oliverchang/sucima/README.md

# Sucima

## What is this?

This is the code for a controller for the Amicus Basic/Advance/Professional
table tennis robots, and a PWA for interfacing with it using bluetooth.
