oliverchang/sucima/pcb/README.md

This directory contains design files for the controller PCB.

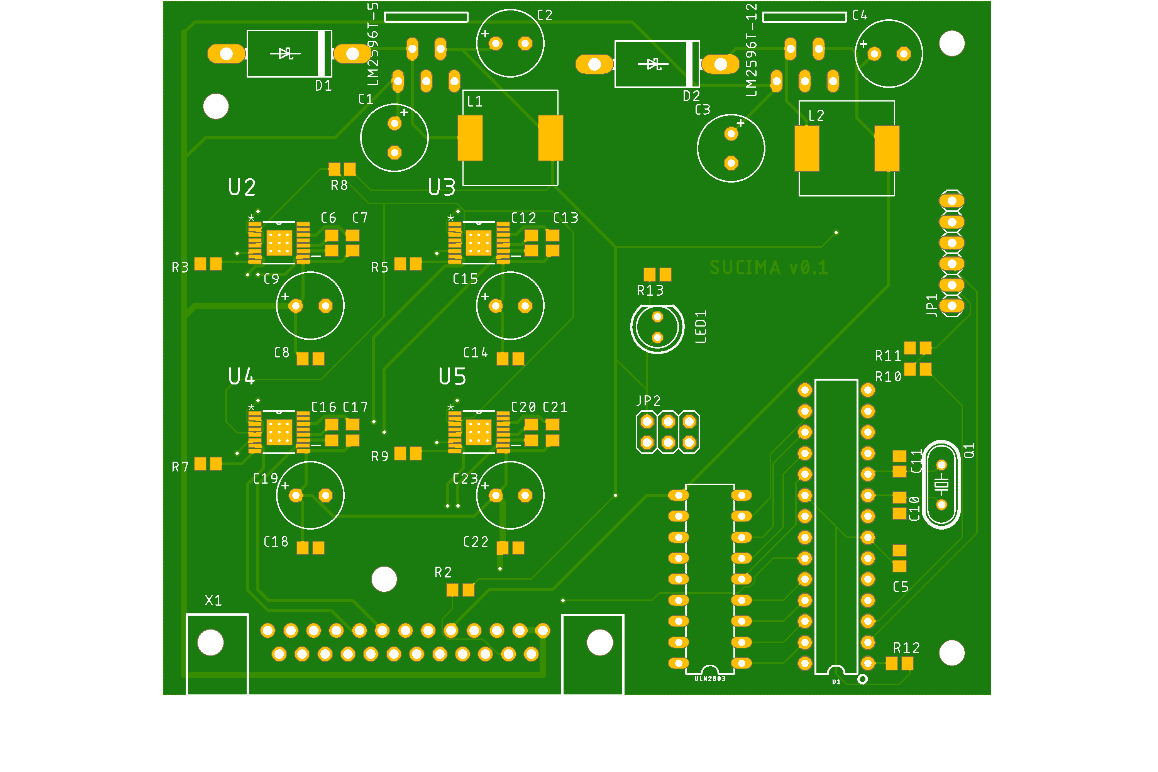
[picture p1: pcb/front.png]
front
