oliverchang/sucima/case/Bottom.stl

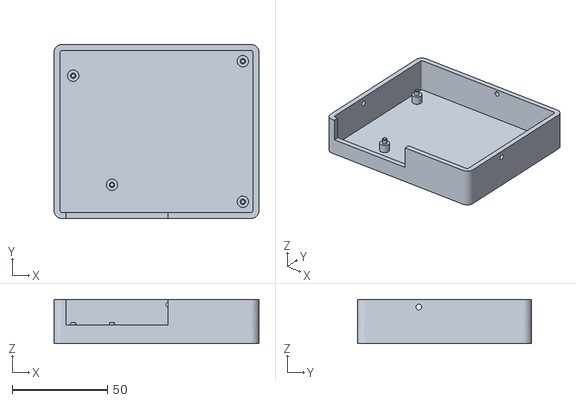
[picture p2: CAD file, 2019-05-30]
case/Bottom.stl
107.4 x 91.2 x 23.2
