oliverchang/sucima/case/Top.stl

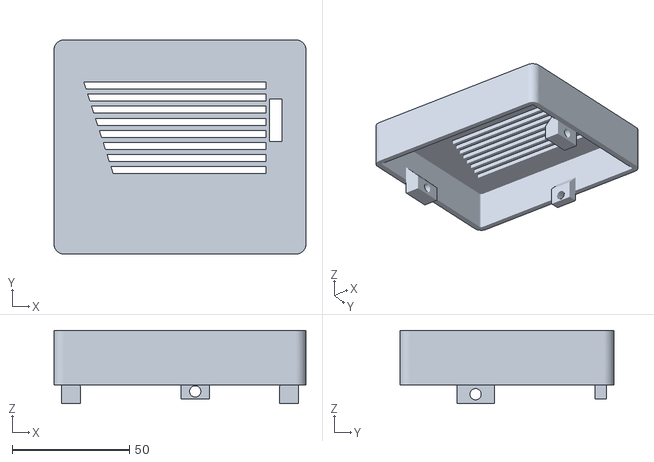
[picture p3: CAD file, 2019-05-30]
case/Top.stl
107.4 x 91.2 x 31.2
