oliverchang/sucima/pcb/board.brd

## EAGLE design pcb/board.brd (2019-04-11)

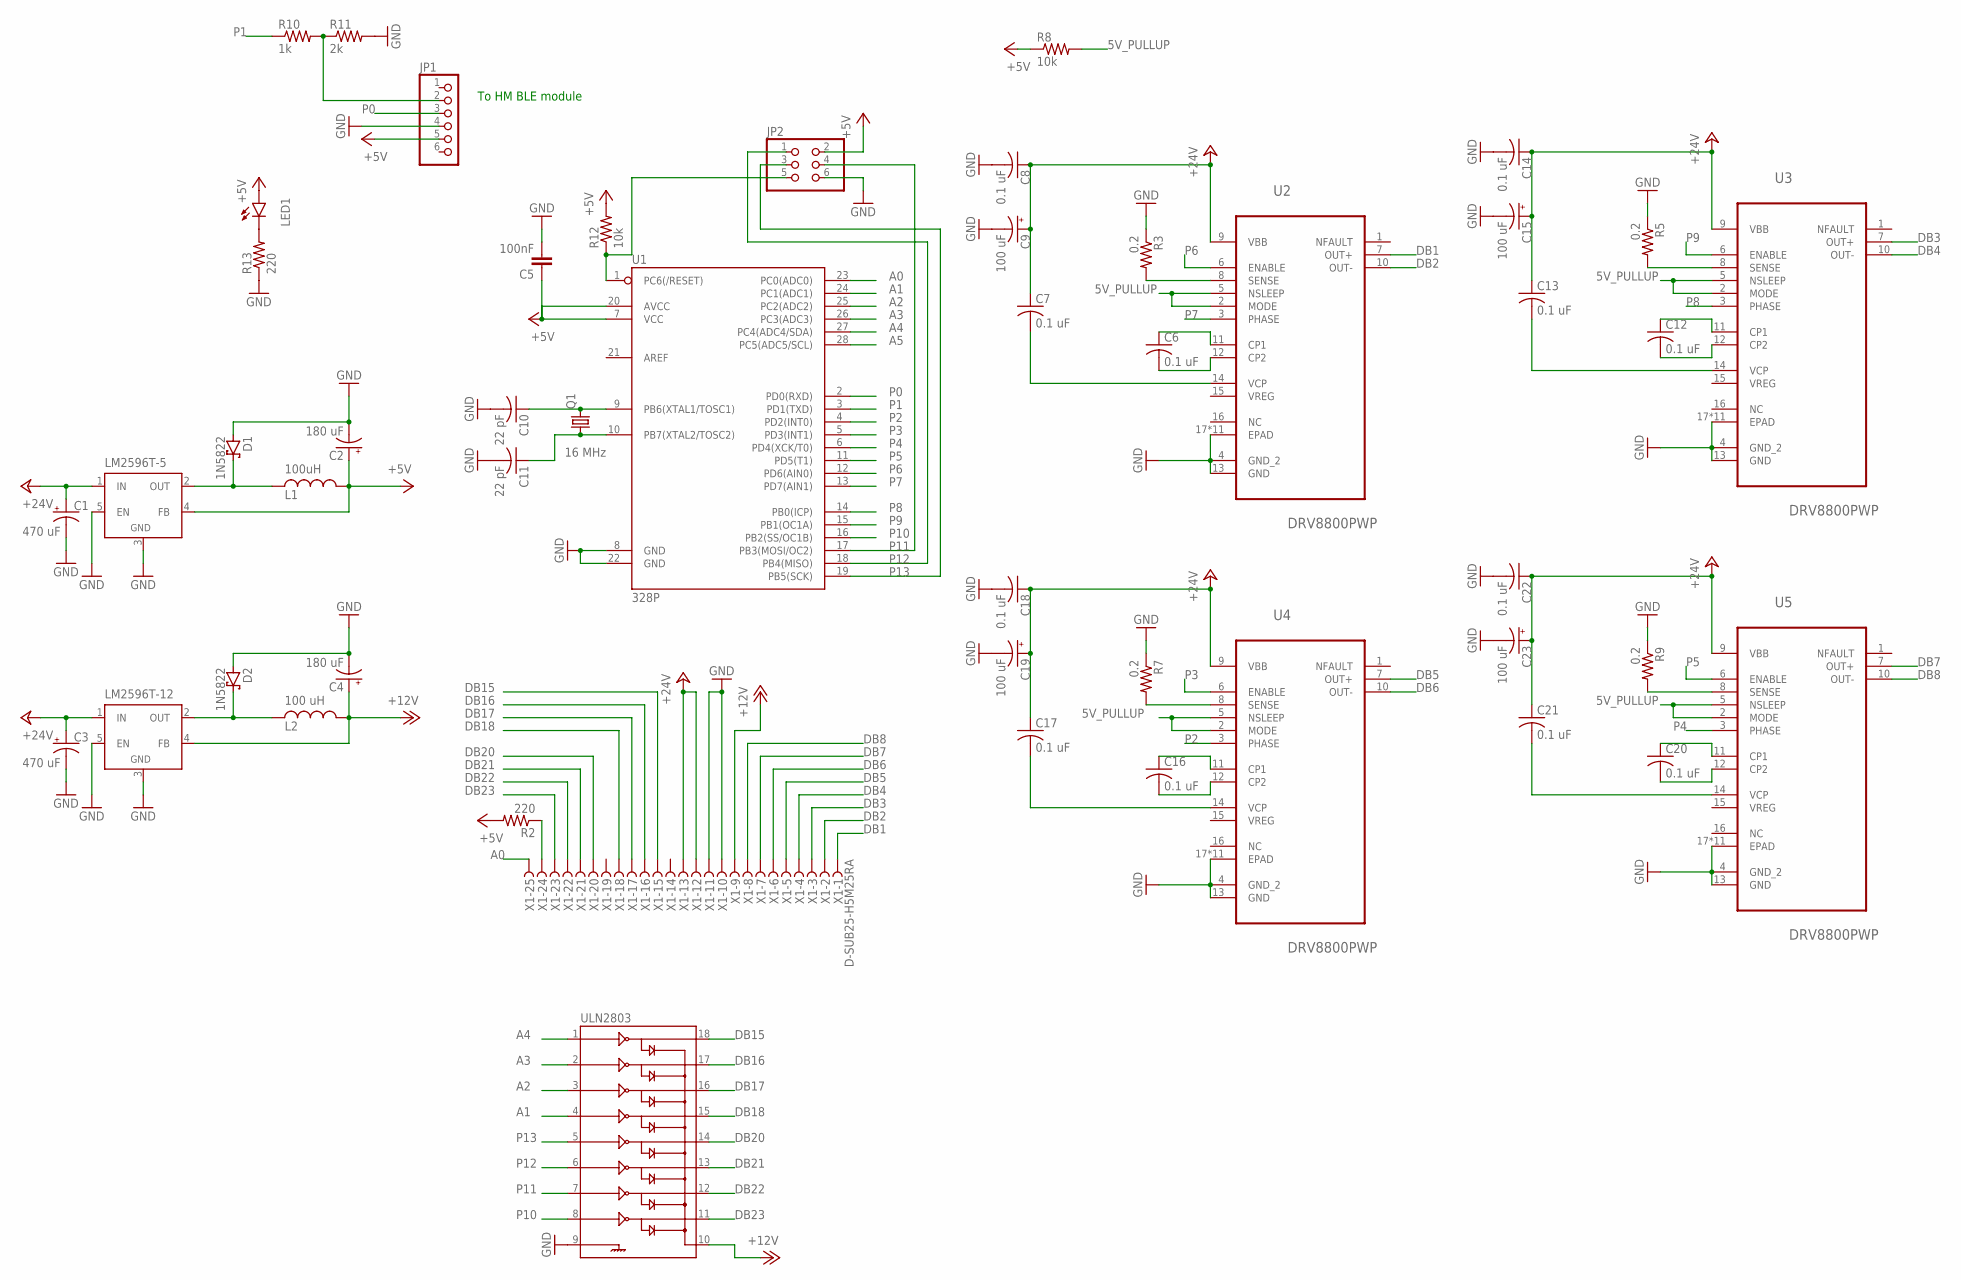
[picture p4: schematic board.sch]

Parts:
C1, C3: 470 uF; E3,5-8
C2, C4: 180 uF; E3,5-8
C5: 100nF; C0805
C6, C7, C8, C12, C13, C14, C16, C17, C18, C20, C21, C22: 0.1 uF; C0805
C9, C15, C19, C23: 100 uF; E3,5-8
C10, C11: 22 pF; C0805
D1, D2: 1N5822; DO201T15
JP1: PINHD-1X6; 1X06
JP2: PINHD-2X3; 2X03
L1: 100uH; SRR1260
L2: 100 uH; SRR1260
LED1: LED5MM
LM2596T-5, LM2596T-12: LM2596TV; TO220-51
Q1: 16 MHz; HC49/S
R2, R13: 220; R0805
R3, R5, R7, R9: 0.2; R0805
R8, R12: 10k; R0805
R10: 1k; R0805
R11: 2k; R0805
U1: 328P; DIP28
U2, U3, U4, U5: DRV8800PWP; SOP65P640X120-17N
ULN2803: ULN2803DIP; DIL18
X1: D-SUB25-H5M25RA; H5M25RA

Connections:
5V_PULLUP: R8.2, U2.2 (MODE), U2.5 (NSLEEP), U3.2 (MODE), U3.5 (NSLEEP), U4.2 (MODE), U4.5 (NSLEEP), U5.2 (MODE), U5.5 (NSLEEP)
+5V: C2.+, C5.1, JP1.5, JP2.2, L1.2, LED1.A, LM2596T-5.4 (FB), R2.2, R8.1, R12.2, U1.7 (VCC), U1.20 (AVCC)
+12V: C4.+, L2.2, LM2596T-12.4 (FB), ULN2803.10, X1.9
+24V: C1.+, C3.+, C7.1, C8.1, C9.+, C13.1, C14.1, C15.+, C17.1, C18.1, C19.+, C21.1, C22.1, C23.+, LM2596T-5.1 (IN), LM2596T-12.1 (IN), U2.9 (VBB), U3.9 (VBB), U4.9 (VBB), U5.9 (VBB), X1.12, X1.13
A0: U1.23 (PC0(ADC0)), X1.25
A1: U1.24 (PC1(ADC1)), ULN2803.4
A2: U1.25 (PC2(ADC2)), ULN2803.3
A3: U1.26 (PC3(ADC3)), ULN2803.2
A4: U1.27 (PC4(ADC4/SDA)), ULN2803.1
A5: U1.28 (PC5(ADC5/SCL))
DB1: U2.7 (OUT+), X1.1
DB2: U2.10 (OUT-), X1.2
DB3: U3.7 (OUT+), X1.3
DB4: U3.10 (OUT-), X1.4
DB5: U4.7 (OUT+), X1.5
DB6: U4.10 (OUT-), X1.6
DB7: U5.7 (OUT+), X1.7
DB8: U5.10 (OUT-), X1.8
DB15: ULN2803.18, X1.15
DB16: ULN2803.17, X1.16
DB17: ULN2803.16, X1.17
DB18: ULN2803.15, X1.18
DB20: ULN2803.14, X1.20
DB21: ULN2803.13, X1.21
DB22: ULN2803.12, X1.22
DB23: ULN2803.11, X1.23
GND: C1.-, C2.-, C3.-, C4.-, C5.2, C8.2, C9.-, C10.2, C11.2, C14.2, C15.-, C18.2, C19.-, C22.2, C23.-, D1.A, D2.A, JP1.4, JP2.6, LM2596T-5.3 (GND), LM2596T-5.5 (EN), LM2596T-12.3 (GND), LM2596T-12.5 (EN), R3.1, R5.1, R7.1, R9.1, R11.2, R13.1, U1.8 (GND), U1.22 (GND), U2.4 (GND_2), U2.13 (GND), U2.17 (EPAD), U2.18 (EPAD), U2.P$1 (EPAD), U2.P$2 (EPAD), U2.P$3 (EPAD), U2.P$4 (EPAD), U2.P$5 (EPAD), U2.P$6 (EPAD), U2.P$7 (EPAD), U2.P$8 (EPAD), U2.P$9 (EPAD), U3.4 (GND_2), U3.13 (GND), U3.17 (EPAD), U3.18 (EPAD), U3.P$1 (EPAD), U3.P$2 (EPAD), U3.P$3 (EPAD), U3.P$4 (EPAD), U3.P$5 (EPAD), U3.P$6 (EPAD), U3.P$7 (EPAD), U3.P$8 (EPAD), U3.P$9 (EPAD), U4.4 (GND_2), U4.13 (GND), U4.17 (EPAD), U4.18 (EPAD), U4.P$1 (EPAD), U4.P$2 (EPAD), U4.P$3 (EPAD), U4.P$4 (EPAD), U4.P$5 (EPAD), U4.P$6 (EPAD), U4.P$7 (EPAD), U4.P$8 (EPAD), U4.P$9 (EPAD), U5.4 (GND_2), U5.13 (GND), U5.17 (EPAD), U5.18 (EPAD), U5.P$1 (EPAD), U5.P$2 (EPAD), U5.P$3 (EPAD), U5.P$4 (EPAD), U5.P$5 (EPAD), U5.P$6 (EPAD), U5.P$7 (EPAD), U5.P$8 (EPAD), U5.P$9 (EPAD), ULN2803.9, X1.10, X1.11
unnamed: D1.C, L1.1, LM2596T-5.2 (OUT)
unnamed: C6.1, U2.11 (CP1)
unnamed: D2.C, L2.1, LM2596T-12.2 (OUT)
unnamed: C6.2, U2.12 (CP2)
unnamed: C7.2, U2.14 (VCP)
unnamed: R2.1, X1.24
unnamed: C10.1, Q1.2, U1.9 (PB6(XTAL1/TOSC1))
unnamed: C11.1, Q1.1, U1.10 (PB7(XTAL2/TOSC2))
unnamed: R3.2, U2.8 (SENSE)
unnamed: C12.1, U3.11 (CP1)
unnamed: C12.2, U3.12 (CP2)
unnamed: C13.2, U3.14 (VCP)
unnamed: R5.2, U3.8 (SENSE)
unnamed: C16.1, U4.11 (CP1)
unnamed: C16.2, U4.12 (CP2)
unnamed: C17.2, U4.14 (VCP)
unnamed: R7.2, U4.8 (SENSE)
unnamed: C20.1, U5.11 (CP1)
unnamed: C20.2, U5.12 (CP2)
unnamed: C21.2, U5.14 (VCP)
unnamed: R9.2, U5.8 (SENSE)
unnamed: JP1.2, R10.2, R11.1
unnamed: JP2.5, R12.1, U1.1 (PC6(/RESET))
unnamed: LED1.K (C), R13.2
P0: JP1.3, U1.2 (PD0(RXD))
P1: R10.1, U1.3 (PD1(TXD))
P2: U1.4 (PD2(INT0)), U4.3 (PHASE)
P3: U1.5 (PD3(INT1)), U4.6 (ENABLE)
P4: U1.6 (PD4(XCK/T0)), U5.3 (PHASE)
P5: U1.11 (PD5(T1)), U5.6 (ENABLE)
P6: U1.12 (PD6(AIN0)), U2.6 (ENABLE)
P7: U1.13 (PD7(AIN1)), U2.3 (PHASE)
P8: U1.14 (PB0(ICP)), U3.3 (PHASE)
P9: U1.15 (PB1(OC1A)), U3.6 (ENABLE)
P10: U1.16 (PB2(SS/OC1B)), ULN2803.8
P11: JP2.4, U1.17 (PB3(MOSI/OC2)), ULN2803.7
P12: JP2.1, U1.18 (PB4(MISO)), ULN2803.6
P13: JP2.3, U1.19 (PB5(SCK)), ULN2803.5

Notes on the sheet:
To HM BLE module

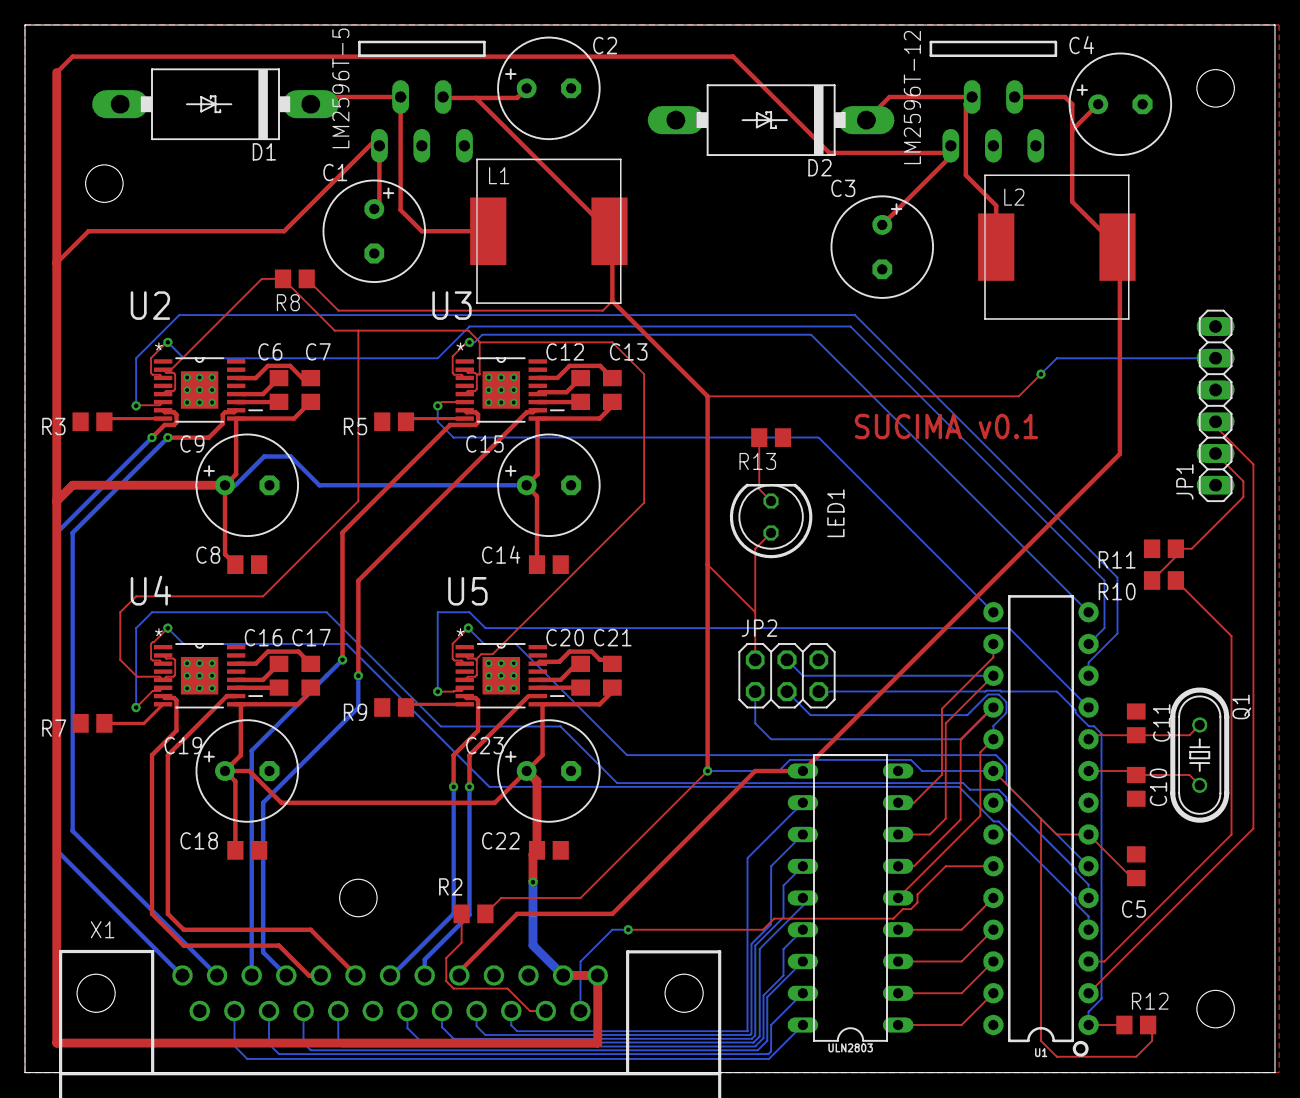
[picture p5: board board.brd from above]

Board: 2 copper layers, 100.0 x 83.8 mm, 50 parts (0 on the bottom side), 64 nets.
