oliverchang/sucima/arduino/sucima/wheel_controller.h

#ifndef _WHEEL_CONTROLLER_H_
#define _WHEEL_CONTROLLER_H_

class WheelController {
 public:
  void SetConfiguration(int spin_angle, int spin_strength, int speed);
  void ReverseJam();
  void Stop();
};

extern WheelController g_wheel_controller;

#endif
