oliverchang/sucima/(commit log)

2019-04-29 Experimental ball jam handling.
    [ball_feed_controller.cpp, ball_feed_controller.h, drill_controller.cpp, drill_controller.h, sucima.cpp, wheel_controller.cpp, wheel_controller.h]
2019-05-02 add reset button
2019-05-30 Add case STL files.
    [Bottom.stl, Top.stl]
2019-06-01 Fix bugs in app.
    - Fix losing bluedtooth connection on loading drill.
    - Reset current ball index on reset.
2019-06-01 move install button
2019-06-01 Fix install button
2019-08-09 fix stop button
2019-08-09 lower sensor threshold
2019-08-10 Adding new ball copies current ball.
